IEA4/Apiary-WiFi_scales/README.md

## Wi-Fi весы со сбором данных и их отправкой телеграм-боту
#### ___Краткое описание :___
Посредством модуля на основе тензодатчика и микросхемы HX711 призводится измерение веса. Результат выводится на семисегментный четырёхразрядный дисплей 74HC595. Последовательность последних измерений передаётся телеграм-боту. В заданный промежуток времени происходит добавление в файл значения результата измерения и времени, соответствующего моменту измерения. По мере накопления данных производится отправка этого файла. По завершению всех необходимых действий устройство уходит в глубокий сон на заданный в коде период времени. Всем процессом управляет Wemos D1 Mini -- плата на базе ESP8266.

#### ___Возможности:___
+ отображение текущего веса на дисплее при каждом пробуждении по таймеру или нажатию на кнопку "ВЗВЕСИТЬ";
+ клик кнопкой "ТАРИРОВАТЬ" от двух до четырёх раз производит тарирование весов, ровно пять -- тарирование, плюс удаление всей имеющейся информации о весе-времени, в том числе файлов;
+ отправка телеграм-боту при каждом пробуждении: текущего напряжения источника питания, последних измерений в виде последовательности, а при накоплении достаточного количества значений, гистограммы для возможности визуально оценить тренд;
+ подытоживание суточного изменения веса в заданное время дня или ночи;
+ сохранение данных в энергонезависимую память, т.е. результаты измерения не теряются в случае отключения питания;
+ отправка телеграм-боту файла результатов измерения-времени для возможности просмотра истории изменения веса автоматически по периоду и по запросу в чате: ввести и отправить "result";
+ точная длительность сна: достигается добавлением поправки к заданному периоду сна, которая высчитывается при каждом пробуждении;
+ при отсутствии связи по вай-фай или при невозможности получить текущее время из отправленного сообщения -- сон на период сна по умолчанию;
+ ОТA-обновление прошивки: скомпилировать bin-файл и скинуть в чат.

#### ___Назначение папок и файлов:___
+ Get_koef_k_for_HX711 --- для определения коэффициента перевода "сырых" значений весов в граммы;
+ Send_recent_long_result ---  прошивка весов;
+ lib --- используемые библиотеки, в основном из [GyverLibs - Arduino библиотеки от AlexGyver](https://github.com/GyverLibs);
- result.txt --- пример файла с весом и временем измерения: первый столбец в файле -- вес, второй -- урезанное unix-время (для оптимизации убраны первые две неизменные цифры в исходном unix-времени);
- Grafic_result.py --- код на Python для построения графика вес-дата, используя данные из result.txt;
- Screen.jpeg --- скриншот окна телеграм-бота -- то, как это будет выглядеть.

#### ___Как пользоваться:___
+ собрать по схеме соединений;
+ используя код из папки Get_koef_k_for_HX711 получить коэффицент перевода сырого веса в граммы;
+ в коде из папки Send_recent_long_result прописать свои настройки вай-фай, телеграм-бота и коэффициент из предыдущего пункта, плюс по желанию те, что в #define и не относится к ножкам ESP8266;
+ когда от бота будет получен файл result.txt, то запустив код из Grafic_result.py (оба файла должны находиться в одной папке) в окне браузера можно получить красивую картинку с графиком изменения веса по датам с возможностью масштабирования.

Версия Arduino IDE: 1.8.16; версия ядра ESP8266: 3.1.2
