IEA4/Apiary-WiFi_scales/Screen.jpeg

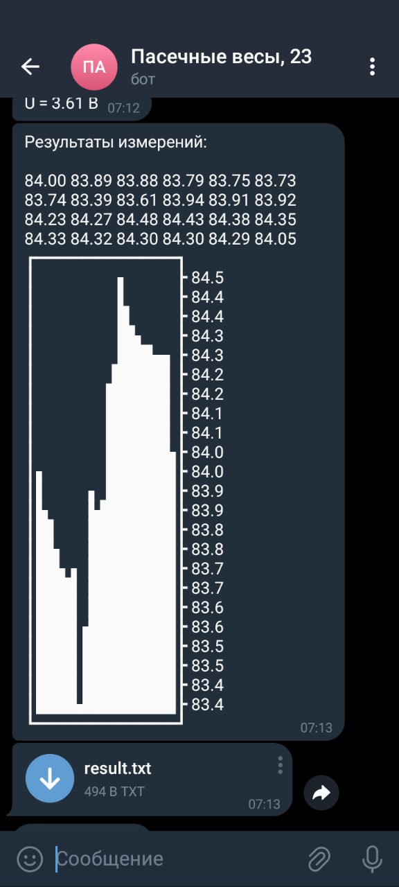
Screen.jpeg
