IEA4/Apiary-WiFi_scales/Схема соединений.jpeg

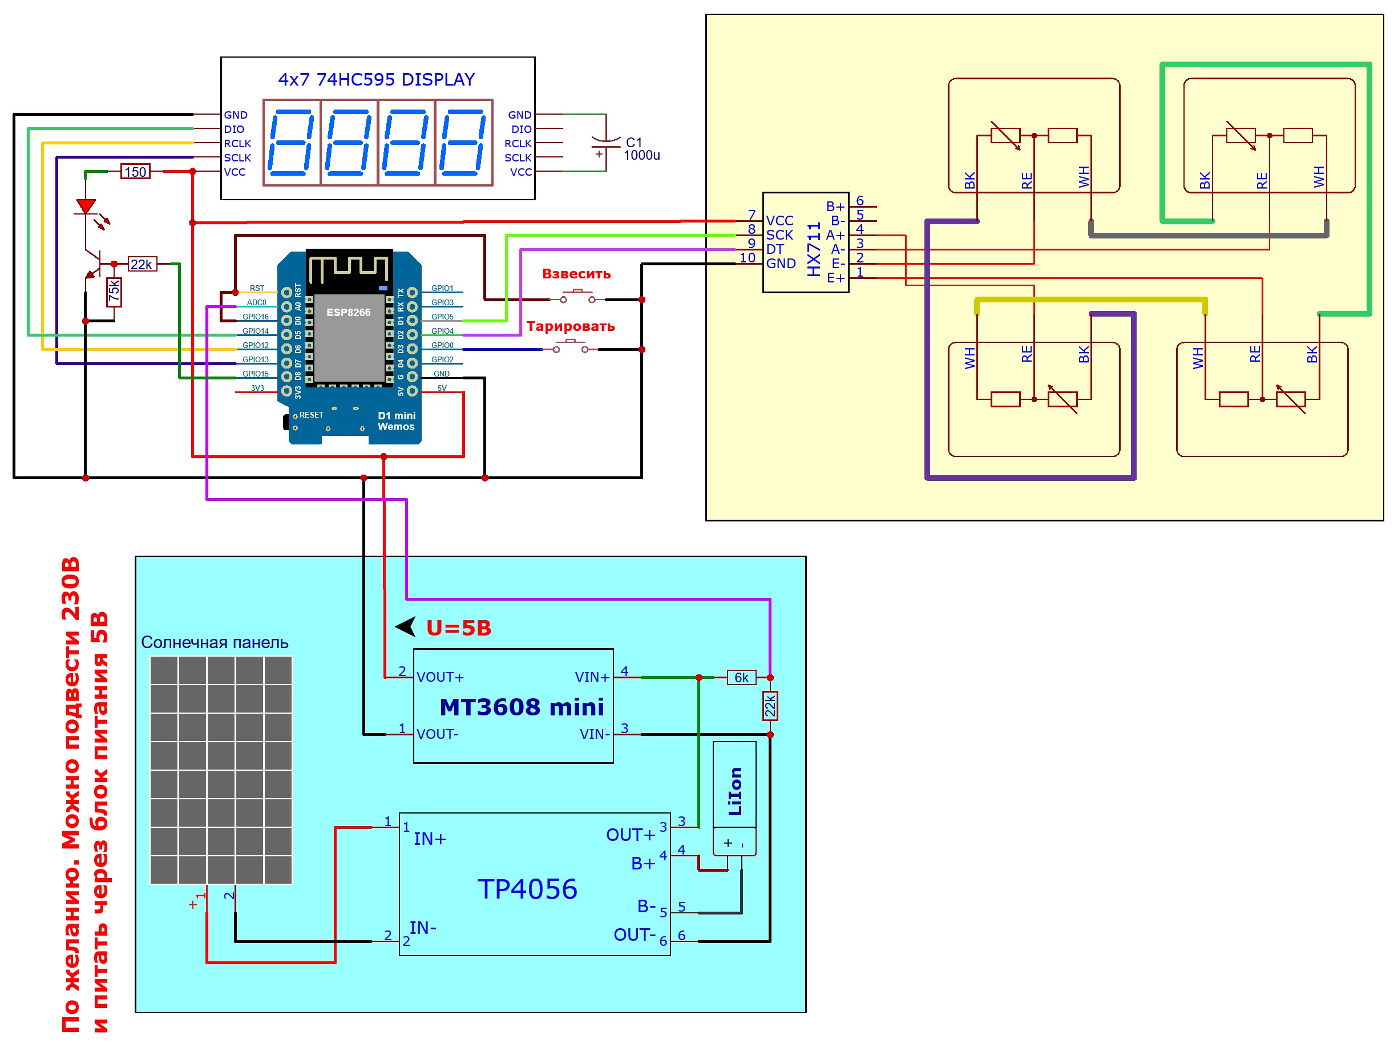
Схема соединений.jpeg
