IEA4/Apiary-WiFi_scales/(commit log)

2024-05-29 Добавил описание
2024-05-29 обновил
2024-12-08 доб ф-ю форм-я сообщ
2024-12-10 добавил OTA
2024-12-19 стаб
2024-12-23 оптимизировал переменные, стаб
2024-12-26 добавил библ, поправил Readme
2025-02-25 OTA и отправка файла по запросу
